scottsilverlabs/raspberrystem-hw-cells/Accel/PCB/board-top.jpg

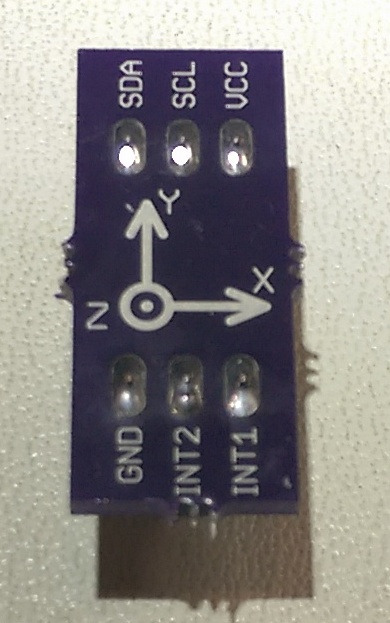
Accel/PCB/board-top.jpg
