scottsilverlabs/raspberrystem-hw-cells/LED_Matrix/PCB/board-bottom.jpg

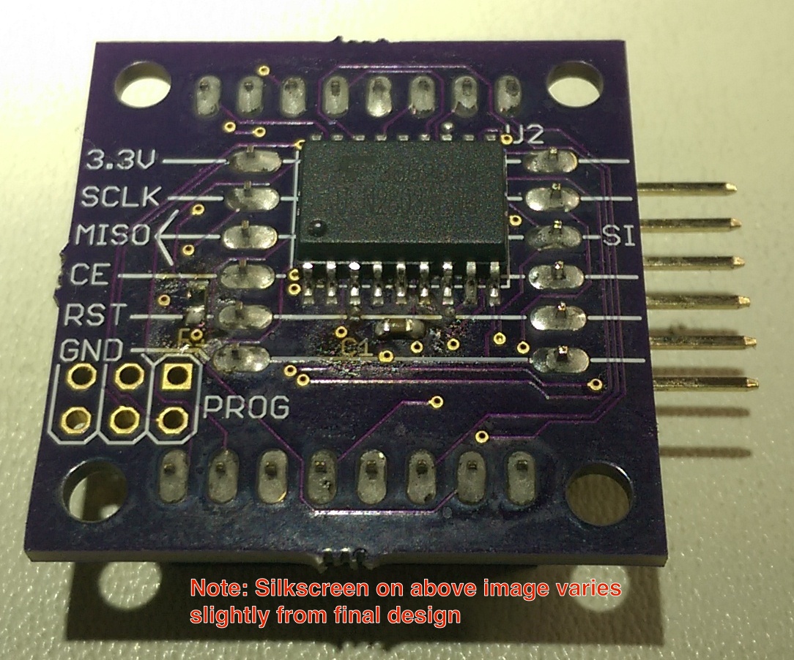
LED_Matrix/PCB/board-bottom.jpg
