scottsilverlabs/raspberrystem-hw-cells/README.md

raspberrystem-hw-cells
======================

raspberrySTEM(TM) Cells hardware schematics and related documents
