scottsilverlabs/raspberrystem-hw-cells/Accel/PCB/board-bottom.jpg

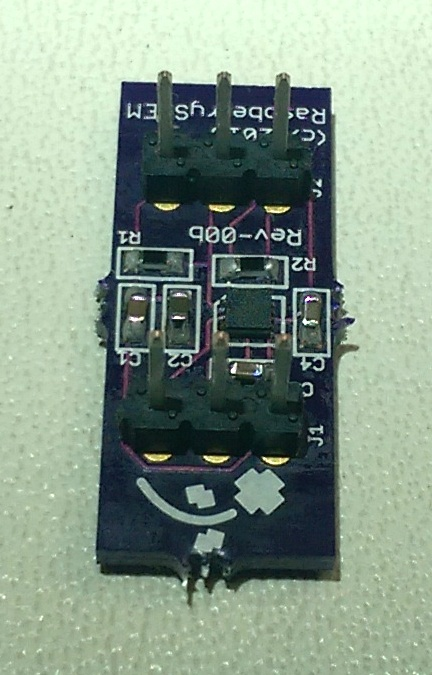
Accel/PCB/board-bottom.jpg
