scottsilverlabs/raspberrystem-hw-cells/LED_Matrix/PCB/board-top.jpg

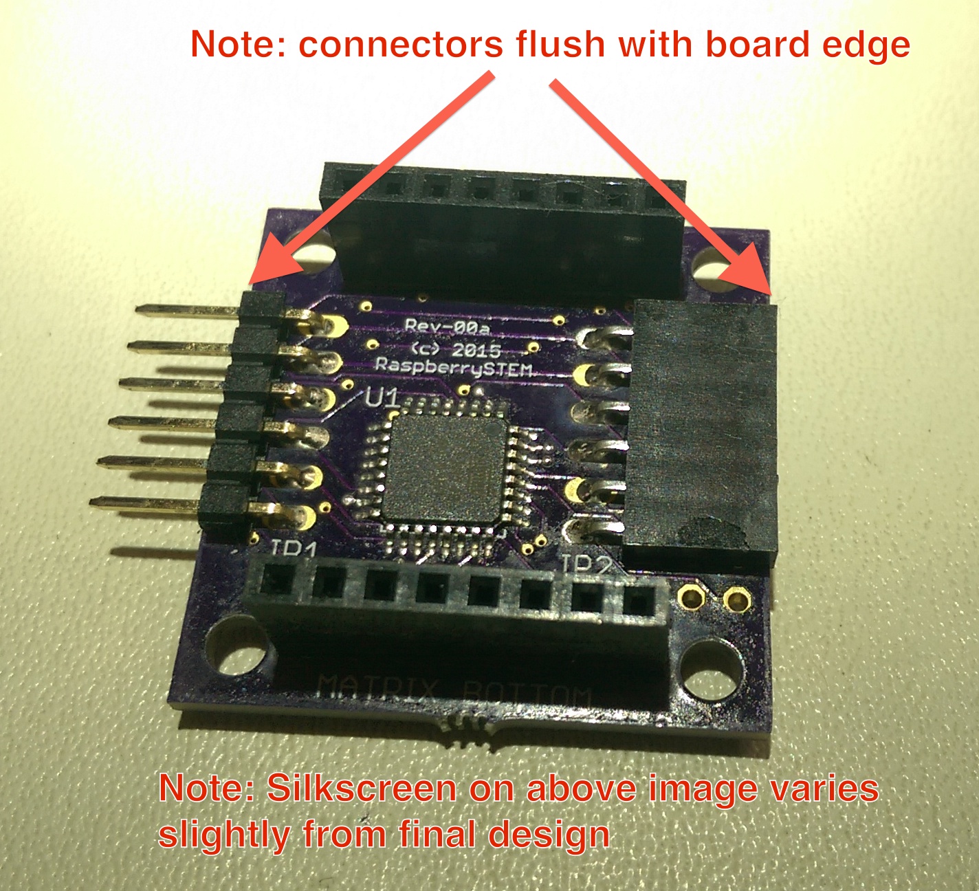
LED_Matrix/PCB/board-top.jpg
