scottsilverlabs/raspberrystem-hw-cells/LED_Matrix/PCB/LED_Matrix_BOM.xls

Item | Qty | Reference Designators | Internal Part # | Manufacturer | Manufacturer Part # | Digikey Part # | Value | Package | Description
1 | 1 | C1 | rs06005 | Taiyo Yuden | LMK107B7105KA-T | 587-1242-1-ND | 1µF | 0603 | CAP CER 1UF 10V 10% X7R 0603
2 | 1 | J1 | rs06055 | Sullins | PPPC061LGBN-RC | S5481-ND |  | Thru hole | CONN FEMALE 6POS .100" R/A GOLD
3 | 2 | J2 J3 | rs06057 | Sullins | PPTC081LFBN-RC | S7006-ND |  | Thru hole | CONN HEADER FEMALE 8POS .1" TIN
4 | 1 | P1 | rs06056 | Harwin | M20-9960645 | 952-2247-ND |  | Thru hole | SIL HORIZ PC TAIL PIN HEADER
5 | 1 | R1 | rs06006 | Yageo | RC0603JR-0710KL | 311-10KGRCT-ND | 10kohms | 0603 | RES SMD 10K OHM 5% 1/10W 0603
6 | 1 | U1 | rs06053 | Atmel | ATTINY48-AUR | ATTINY48-AURCT-ND |  | 32-TQFP | IC MCU 8BIT 4KB FLASH 32TQFP
7 | 1 | U2 | rs06052 | Toshiba Semiconductor | ULN2803AFWG,C,EL | ULN2803AFWGCELTR-ND |  | 18-SOIC | TRANS 8NPN DARL 50V 0.5A 18SOL
