scottsilverlabs/raspberrystem-hw-cells/Accel/PCB/AccelBreakout_BOM.xls

Item | Qty | Reference Designators | Internal Part # | Manufacturer | Manufacturer Part # | Digikey Part # | Value | Package | Description
1 | 1 | U1 | rs06007 | Freescale Semiconductor | MMA8653FCR1 | MMA8653FCR1TR-ND |  | 10-VFDFN | IC ACCELEROMETER 3AXIS 10DFN
2 | 2 | R1 R2 | rs06006 | Yageo | RC0603FR-0710KL | 311-10.0KHRCT-ND | 10kohms | 0603 | RES 10K OHM 1/8W 1% 0603 SMD
3 | 3 | C1 C3 C4 | rs06004 | Murata | GRM188R71C104KA01D | 490-1532-1-ND | 0.1µF | 0603 | CAP CER 0.1UF 16V 10% X7R 0603
4 | 1 | C2 | rs06005 | Murata | GRM188R61A105KA61D | 490-1543-1-ND | 1µF | 0603 | CAP CER 1UF 10V 10% X5R 0603
5 | 2 | J1 J2 | rs06003 | Harwin Inc. | M20-9990346 | 952-2264-ND |  | Thru hole | SIL VERTICAL PC TAIL PIN HEADER
