scottsilverlabs/raspberrystem-hw-cells/LED_Matrix/PCB/LED_Matrix.brd

## EAGLE design LED_Matrix/PCB/LED_Matrix.brd (2015-03-03)

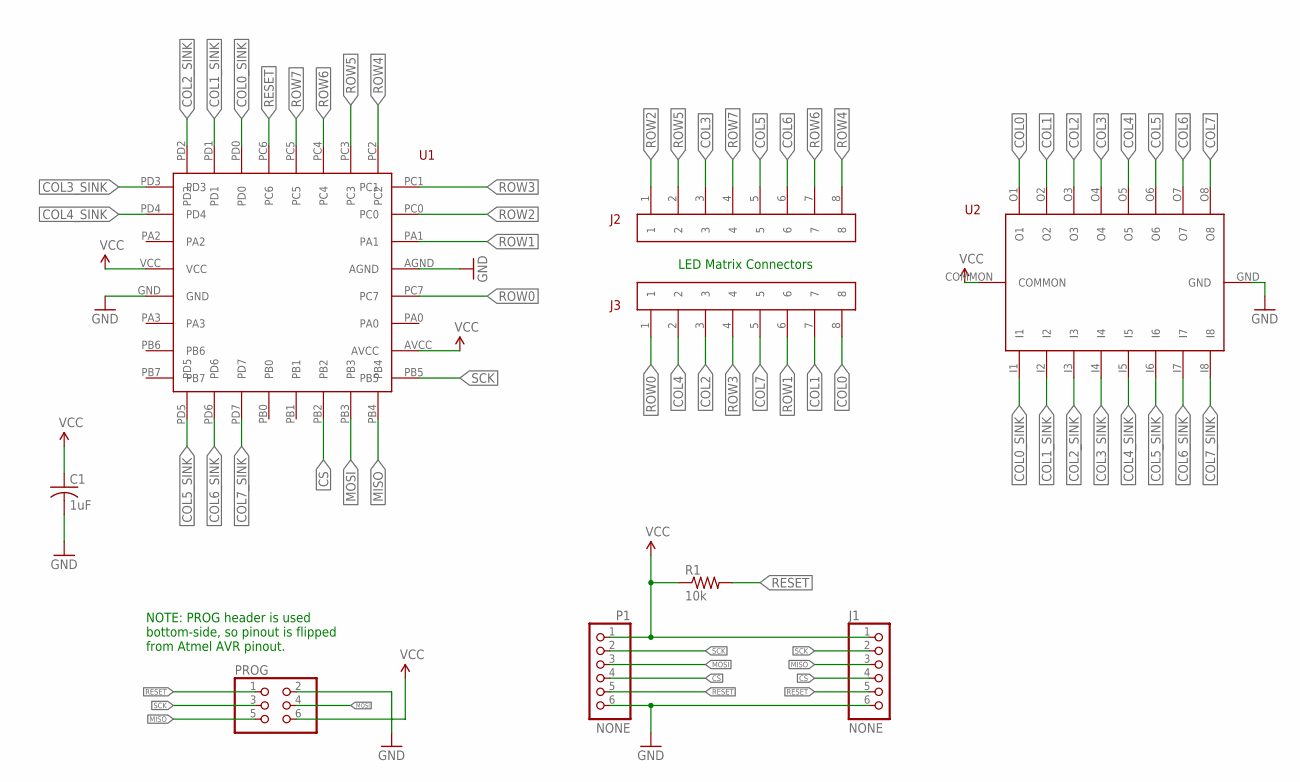
[picture p5: schematic LED_Matrix.sch]

Parts:
C1: 1uF; C0603
J1: NONE; 1X06
J2, J3: HEADER-1X8
P1: NONE; 1X06
PROG: NONE; 2X03
R1: 10k; R0603
U1: ATTINY48
U2: ULN2803AFWG

Connections:
COL0: J3.8, U2.O1
COL0_SINK: U1.PD0, U2.I1
COL1: J3.7, U2.O2
COL1_SINK: U1.PD1, U2.I2
COL2: J3.3, U2.O3
COL2_SINK: U1.PD2, U2.I3
COL3: J2.3, U2.O4
COL3_SINK: U1.PD3, U2.I4
COL4: J3.2, U2.O5
COL4_SINK: U1.PD4, U2.I5
COL5: J2.5, U2.O6
COL5_SINK: U1.PD5, U2.I6
COL6: J2.6, U2.O7
COL6_SINK: U1.PD6, U2.I7
COL7: J3.5, U2.O8
COL7_SINK: U1.PD7, U2.I8
CS: J1.4, P1.4, U1.PB2
GND: C1.2, J1.6, P1.6, PROG.2, U1.AGND, U1.GND, U2.GND
MISO: J1.3, PROG.5, U1.PB4
MOSI: P1.3, PROG.4, U1.PB3
RESET: J1.5, P1.5, PROG.1, R1.2, U1.PC6
ROW0: J3.1, U1.PC7
ROW1: J3.6, U1.PA1
ROW2: J2.1, U1.PC0
ROW3: J3.4, U1.PC1
ROW4: J2.8, U1.PC2
ROW5: J2.2, U1.PC3
ROW6: J2.7, U1.PC4
ROW7: J2.4, U1.PC5
SCK: J1.2, P1.2, PROG.3, U1.PB5
VCC: C1.1, J1.1, P1.1, PROG.6, R1.1, U1.AVCC, U1.VCC, U2.COMMON

Notes on the sheet:
NOTE: PROG header is used bottom-side, so pinout is flipped from Atmel AVR pinout.
LED Matrix Connectors

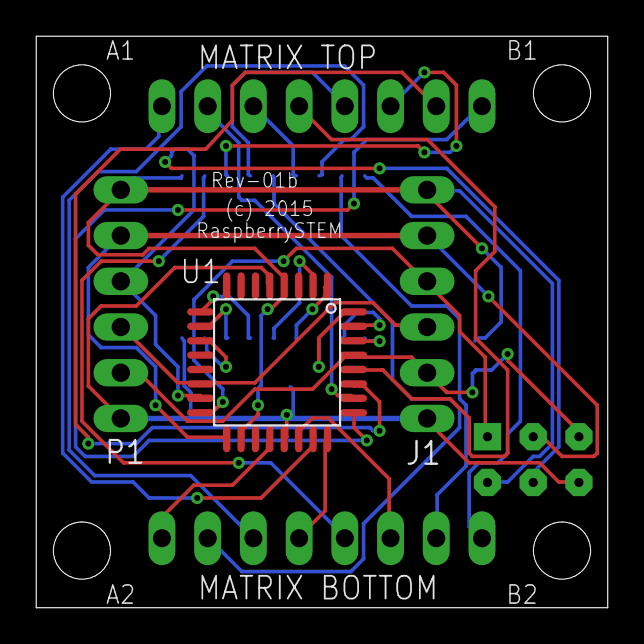
[picture p6: board LED_Matrix.brd from above]

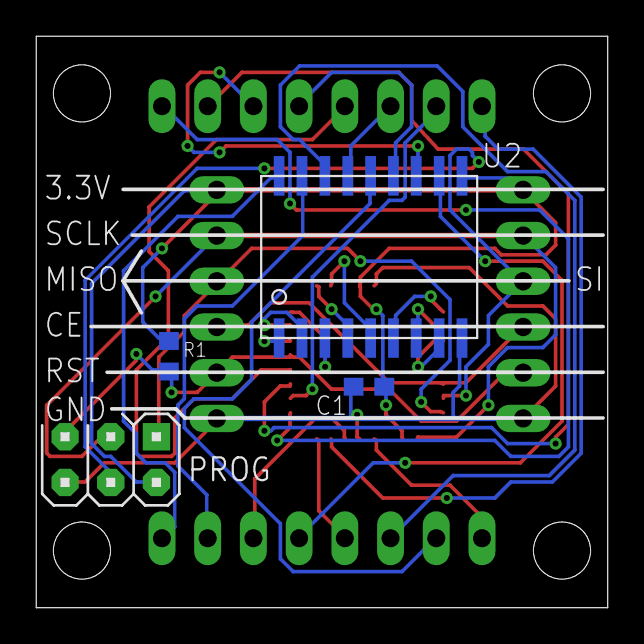
[picture p7: board LED_Matrix.brd from below]

Board: 2 copper layers, 31.8 x 31.8 mm, 9 parts (3 on the bottom side), 31 nets.
