scottsilverlabs/raspberrystem-hw-cells/Accel/PCB/AccelBreakout.brd

## EAGLE design Accel/PCB/AccelBreakout.brd (2015-01-23)

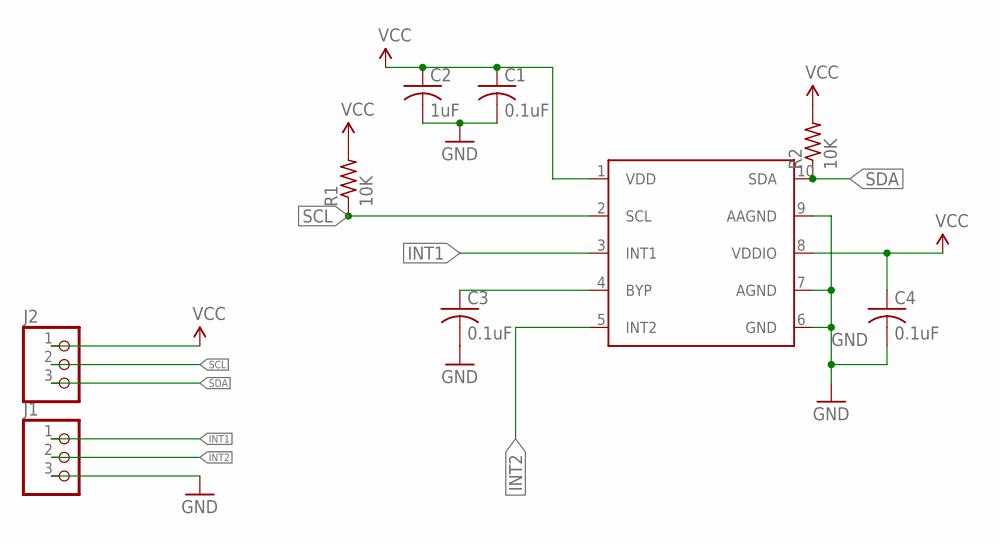
[picture p8: schematic AccelBreakout.sch]

Parts:
C1, C3, C4: 0.1uF; C0603
C2: 1uF; C0603
J1, J2: PINHD-1X3; 1X03
R1, R2: 10K; R0603
U1: MMA8653FCR1

Connections:
GND: C1.2, C2.2, C3.2, C4.2, J1.3, U1.6 (GND), U1.7 (AGND), U1.9 (AAGND)
INT1: J1.1, U1.3 (INT1)
INT2: J1.2, U1.5 (INT2)
unnamed: C3.1, U1.4 (BYP)
SCL: J2.2, R1.1, U1.2 (SCL)
SDA: J2.3, R2.1, U1.10 (SDA)
VCC: C1.1, C2.1, C4.1, J2.1, R1.2, R2.2, U1.1 (VDD), U1.8 (VDDIO)

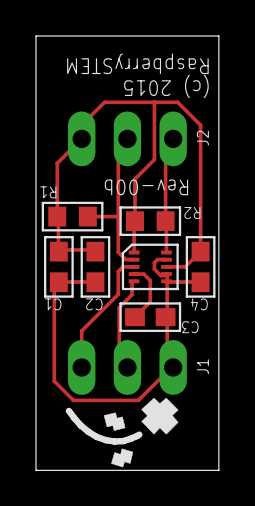
[picture p9: board AccelBreakout.brd from above]

Board: 2 copper layers, 10.2 x 24.1 mm, 9 parts (0 on the bottom side), 7 nets.
