scottsilverlabs/raspberrystem-hw-cells/Linkable_LED_Matrix PCB/Linkable_LED_Matrix_Thru_Full_Mount.brd

## EAGLE design Linkable_LED_Matrix PCB/Linkable_LED_Matrix_Thru_Full_Mount.brd (2014-07-24)

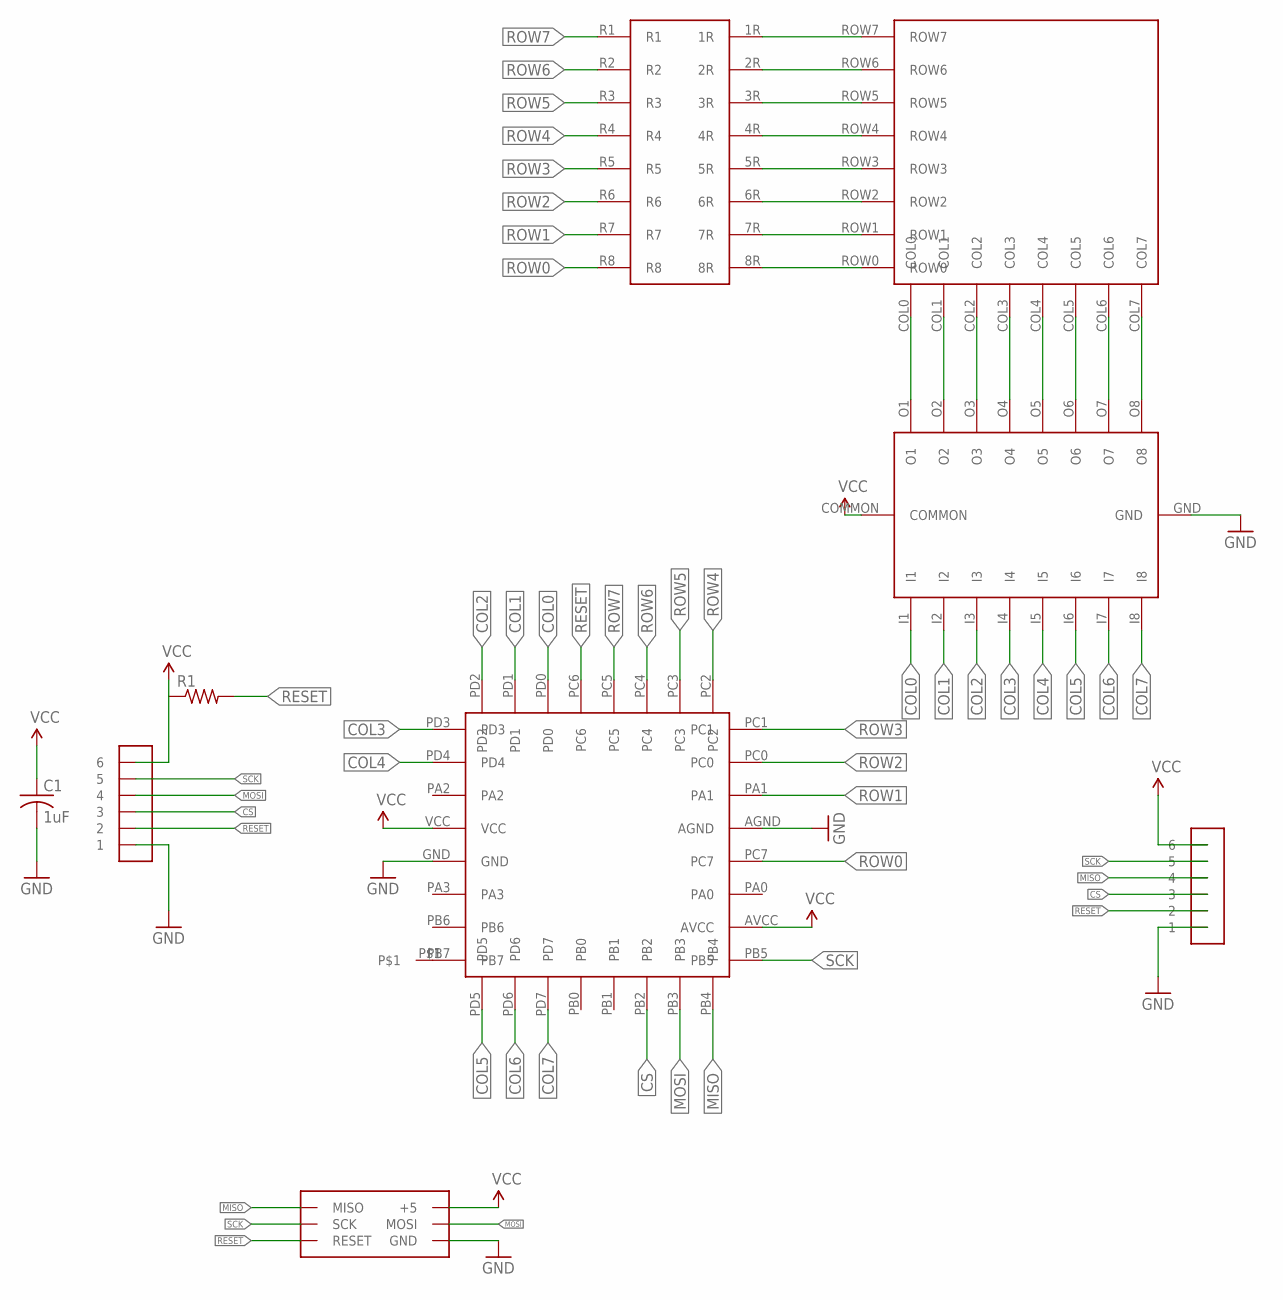
[picture p10: schematic Linkable_LED_Matrix_Thru_Full_Mount.sch]

Parts:
C1: 1uF; C0603
R1: R-US_R0603; R0603
U$1: ATTINY48
U$2: ULN2803AFWG
U$3: 8X8_LED_MATRIX
U$4: RES_ARRAY
U$5: 1X1MM_PAD
U$6, U$7: DIP1X6MALE
U$9: DIP2X3MALE

Connections:
COL0: U$1.PD0, U$2.I1
COL1: U$1.PD1, U$2.I2
COL2: U$1.PD2, U$2.I3
COL3: U$1.PD3, U$2.I4
COL4: U$1.PD4, U$2.I5
COL5: U$1.PD5, U$2.I6
COL6: U$1.PD6, U$2.I7
COL7: U$1.PD7, U$2.I8
CS: U$1.PB2, U$6.3, U$7.3
GND: C1.2, U$1.AGND, U$1.GND, U$2.GND, U$6.1, U$7.1, U$9.GND
MISO: U$1.PB4, U$7.4, U$9.MISO
MOSI: U$1.PB3, U$6.4, U$9.MOSI
unnamed: U$2.O1, U$3.COL0
unnamed: U$2.O2, U$3.COL1
unnamed: U$2.O3, U$3.COL2
unnamed: U$2.O4, U$3.COL3
unnamed: U$2.O5, U$3.COL4
unnamed: U$2.O6, U$3.COL5
unnamed: U$2.O7, U$3.COL6
unnamed: U$2.O8, U$3.COL7
unnamed: U$1.PB7, U$5.P$1
unnamed: U$3.ROW7, U$4.1R
unnamed: U$3.ROW6, U$4.2R
unnamed: U$3.ROW5, U$4.3R
unnamed: U$3.ROW4, U$4.4R
unnamed: U$3.ROW3, U$4.5R
unnamed: U$3.ROW2, U$4.6R
unnamed: U$3.ROW1, U$4.7R
unnamed: U$3.ROW0, U$4.8R
RESET: R1.2, U$1.PC6, U$6.2, U$7.2, U$9.RESET
ROW0: U$1.PC7, U$4.R8
ROW1: U$1.PA1, U$4.R7
ROW2: U$1.PC0, U$4.R6
ROW3: U$1.PC1, U$4.R5
ROW4: U$1.PC2, U$4.R4
ROW5: U$1.PC3, U$4.R3
ROW6: U$1.PC4, U$4.R2
ROW7: U$1.PC5, U$4.R1
SCK: U$1.PB5, U$6.5, U$7.5, U$9.SCK
VCC: C1.1, R1.1, U$1.AVCC, U$1.VCC, U$2.COMMON, U$6.6, U$7.6, U$9.5V (+5)

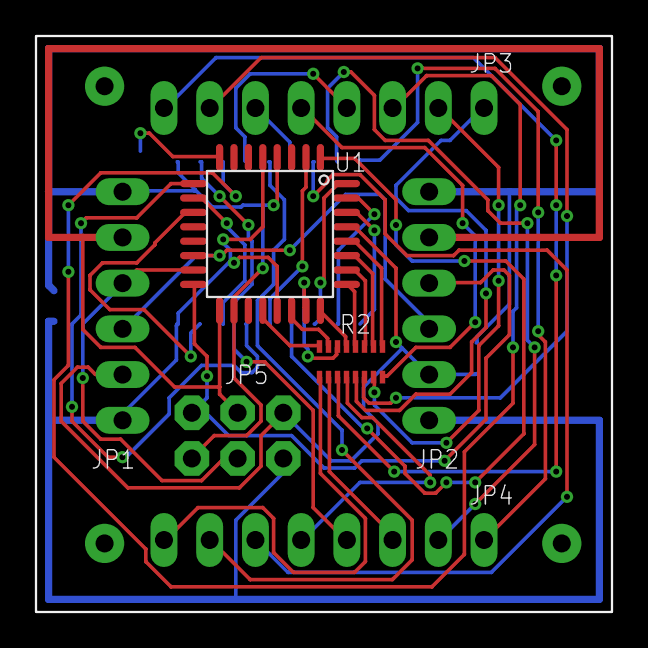
[picture p11: board Linkable_LED_Matrix_Thru_Full_Mount.brd from above]

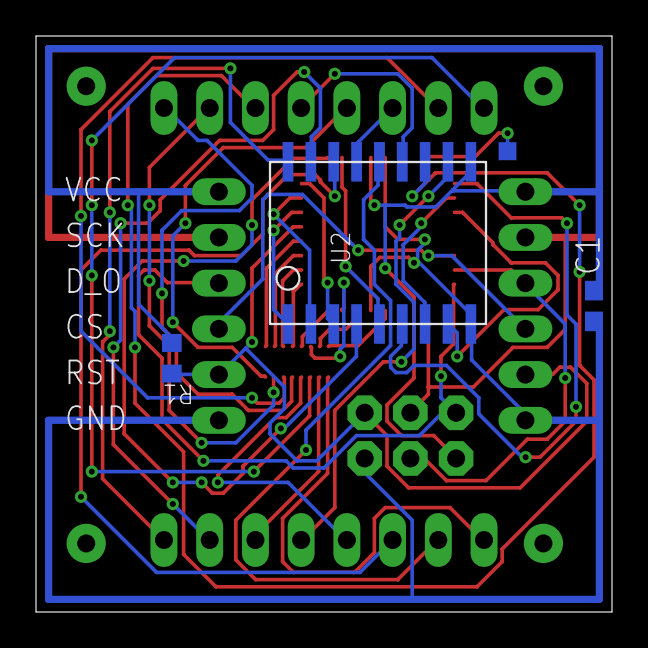
[picture p12: board Linkable_LED_Matrix_Thru_Full_Mount.brd from below]

Board: 2 copper layers, 32.0 x 32.0 mm, 10 parts (5 on the bottom side), 40 nets.
