scottsilverlabs/raspberrystem-hw-cells/(threads)

Thread 7 (2014-10-01):

Row issue: leakage current across other LEDs in the same row.

brian-silverman, 2014-10-01:

Closed 2016-03-24.

Thread 8 (2014-10-01):

Power issue - LEDs should draw up to 25mA per LED

brian-silverman, 2014-10-01:
Power issue - LEDs should draw up to 25mA per LED, max 200mA per row.  Need to change current limiting resistors, or may need some redesign if current sink is not working as expected.

Closed 2016-03-24.
