scottsilverlabs/raspberrystem-hw-cells/(commit log)

2014-06-25 Added Accelerometer and Linkable LED Matrix files
    [AccelBreakout.brd, AccelBreakout.sch, Linkable_LED_Matrix_BOM.xls, Linkable_LED_Matrix_Seperate_RES.brd, Linkable_LED_Matrix_Seperate_RES.sch, Linkable_LED_Matrix_Thru_Full_Mount.brd, Linkable_LED_Matrix_Thru_Full_Mount.sch]
2014-06-26 Added BOM for accel dev board
    [AccelBreakout_BOM.xls]
2014-06-26 Minimized the Accel PCB layout
    [AccelBreakout.brd]
2014-07-18 Fixed silk screen and shifted JP2 very slightly
    [Linkable_LED_Matrix_Thru_Full_Mount.brd, Linkable_LED_Matrix_Thru_Full_Mount.sch]
2014-07-18 Fixed silk screen and added accelerometer directions
    [AccelBreakout.brd, AccelBreakout.sch]
2014-07-22 Added bypass cap and removed deprecated seperate resistor design
    [Linkable_LED_Matrix_Seperate_RES.brd, Linkable_LED_Matrix_Seperate_RES.sch, Linkable_LED_Matrix_Thru_Full_Mount.brd, Linkable_LED_Matrix_Thru_Full_Mount.sch]
2014-07-22 Fixed text and arrow orientaiton for accel PCB
    [AccelBreakout.brd, AccelBreakout.sch]
2014-07-24 added silk screen to linkable LED matrix board
    [Linkable_LED_Matrix_Thru_Full_Mount.brd]
2014-08-12 Added C1 to BOM
    [Linkable_LED_Matrix_BOM.xls]
2014-09-19 Split 1x6 header into 2 1x3 headers 300 mils apart to fit over center bridge on breadboard
    [AccelBreakout.brd, AccelBreakout.sch]
2014-09-21 Holes are now equidistant from the edges and the resistor array was removed
    [Linkable_LED_Matrix_Thru_Full_Mount.brd, Linkable_LED_Matrix_Thru_Full_Mount.sch]
2014-09-26 Mounting holes are now equidistant apart, removed uneeded resistor package
    [Linkable_LED_Matrix.brd, Linkable_LED_Matrix.sch]
2014-12-17 Rearranging file hierarchy for consistency
    [AccelBreakout.brd, AccelBreakout.sch, AccelBreakout_BOM.xls, Linkable_LED_Matrix.brd, Linkable_LED_Matrix.sch, Linkable_LED_Matrix_BOM.xls]
2014-12-18 Refactored - commented, cleaned, removed potential race conditions
    Resolves issue #7 by increasing frame rate (previously frame rate was as fast
    as possible, now its configurable and currently set to 120HZ)
    [LED_Matrix_ATINY48.c]
2014-12-18 ISR optimizations
    Faster ISR means SPI working up to 1MHz (intermittently) or 500kHz reliably. (Previous record was
    500kHz).
2014-12-19 Additional ISR optimizations for higher SPI clock speed.
    Now running at 1MHz SPI clock reliably. Tested overnight repeating
    led_matrix.init_grid() for one LED Matrix.
2014-12-19 Initial POST (Power On Self Test)
2014-12-20 Converted colors from linear PWM mapping to gemoetric.
    Linear colors converted directly to PWM appear too different on the low end
    (and conversely too similar on the high end). Instead, convert all colors
    to a PWM using an approximate geometric sequence of 16 values, with the
    ratio 1.32 (determined experimentally to give a max value of 63).
2014-12-22 Corrected all lingering gcc warnings.
    Some, like for memset() were broken code.
    [LED_Matrix_ATINY48.c]
2014-12-23 led - matrix - new mounting holes, rerouted...
    Added new mounting hole strategy - holes are 0.125" unplated, and can mount
    with m2.5 screws, or plastic pressfit standoffs.
    Silikscreen cleaned up - all labels moved away from vias, and placed upright.
    Added clear labelling for all parts, and put horizontal lines across the board
    showing chaining connectivity.
    Put ATTINY's decoupling cap closer to part.
    12 mil traces for passthru VCC/GND/SCLK. All others 8mil.
    Removed unused test pad.
    [Linkable_LED_Matrix.brd, Linkable_LED_Matrix.sch]
2014-12-23 cleanup to pass error checks
    Stop mask fails checks for silkscreen written on top of copper, but OshPark
    automatically trims that so I've approved it all. It would be a pain to trim
    it all, so I won't (unless we need to later).
    [Linkable_LED_Matrix.brd, Linkable_LED_Matrix.sch]
2014-12-24 led matrix - adjust text on silkscreen
    [Linkable_LED_Matrix.brd]
2014-12-27 accel - size, layout, labels
    Adjusted size to be 0.6" DIP spacing. Better orientation and position of all
    labels. Completely rerouted to remove all vias.
    [AccelBreakout.brd, AccelBreakout.sch]
2014-12-27 accel - adjusted direction symbol, replaced parts
    Some old parts were missing from raspberrystem.lbr.
    [AccelBreakout.brd, AccelBreakout.sch]
2014-12-30 accel - Resized board and swapped orientation label to bottom
    [AccelBreakout.brd, LED_Matrix.brd, LED_Matrix.sch, Linkable_LED_Matrix_BOM.xls]
2014-12-31 led matrix - Moved library parts local. Added rev and copyright.
    [LED_Matrix.brd, LED_Matrix.sch]
2014-12-31 led matrix - fixed silkscreen and flipped prog header
    [LED_Matrix.brd, LED_Matrix.sch]
2015-01-05 accel - Added silkscreen copyright and rev
    [AccelBreakout.brd]
2015-01-05 accel - Moved parts to local library (from raspberrystem.lbr)
    [AccelBreakout.brd, AccelBreakout.sch]
2015-01-05 accel - Added document frame
    [AccelBreakout.sch]
2015-01-05 accel - Fixed coordinate silkscreen label
    [AccelBreakout.brd, AccelBreakout.sch]
2015-01-22 accel - silkscreen and board size changes
    Box around R/Cs. Increased board size to fit better pin labels
    [AccelBreakout.brd, AccelBreakout.sch]
2015-01-23 accel - slight adjustment to silkscreen text
    [AccelBreakout.brd]
2015-01-23 accel - rev 00b - Added Rstem logo
    [AccelBreakout.brd]
2015-01-30 led matrix - resolved SPI chaining issues
    Because store and show ping-pong shift-registers were used, the data coming out
    of the MISO for the last LED in the chain was incorrect. This is not strictly
    an issue, because its passed the end of the chain. However, this is now
    changed to a perhaps better approach using only one shift-register.
    [LED_Matrix_ATINY48.c]
2015-02-20 led matrix - Smaller PROG header holes, minor silkscreen changes. Rev-01a.
    Smaller PROG holes allow pogo pins to work without getting stuck in the holes.
    [LED_Matrix.brd, LED_Matrix.sch]
2015-02-25 matrix - Optimized rate at wihich SPI data can be received without overruns.
2015-02-25 matrix - Fixed memcpy() warnings
    [LED_Matrix_ATINY48.c]
2015-02-25 matrix - Fix for suprious interrupt after POST. Version 1.2
    [LED_Matrix_ATINY48.c]
2015-03-03 matrix - Rev-01b - Adjust size, mouting holes, split matrix connector. No routing changes.
    Dimensionsional, mounting, silkscreen and schematic changes. (actually - there
    was one very minor routing adjustment where a DRC check failed).
    Changes:
    - Board was 1260x1260mils: changed to correct 1250x1250, which is the size
    of the LED matrix.
    - Mouting holes where 1010 mils apart, and still would hit the matrix
    headers with #4 screws. Rather than do the correct 1000mils, went to
    1050 mils, which allow us only of one pair of mounting pins at a time.
    This is good because it allows all boards in a chain to use exactly two
    mounting holes. Holes are now also la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
    [LED_Matrix.brd, LED_Matrix.sch]
2015-03-03 matrix - Added BOM
    [LED_Matrix_BOM.xls]
2015-03-03 matrix - added gerbers
    Generated via CAM Processor file sfe-gerb274x.cam from www.sparkfun.com
    [LED_Matrix.GBL, LED_Matrix.GBO, LED_Matrix.GBS, LED_Matrix.GTL, LED_Matrix.GTO, LED_Matrix.GTP, LED_Matrix.GTS]
2015-03-19 accel - Added accel IC pin name to schematic
    [AccelBreakout.sch]
2015-03-19 accel - BOM
    [AccelBreakout_BOM.xls]
2015-03-21 led matrix - BOM - added "Thru hole" to applicable parts
    [LED_Matrix_BOM.xls]
2015-04-15 pcb packaging - Added board rev to output zip file package
2015-04-15 accel packaging - Created initial accel package.
    Also, updated Makefile to include JPG images
    [AccelBreakout.GBL, AccelBreakout.GBO, AccelBreakout.GBS, AccelBreakout.GTL, AccelBreakout.GTO, AccelBreakout.GTP, AccelBreakout.GTS]
2015-04-15 packaging - Moved packaging files into raspberrystem-hw-base repo
    [AccelBreakout_BOM.xls]
2015-04-15 matrix/accel - Added board fab notes images
